miek/LibreCAL/Hardware/LibreCAL/LibreCAL.kicad_pcb

## KiCad design Hardware/LibreCAL/LibreCAL.kicad_pcb (2024-06-10)

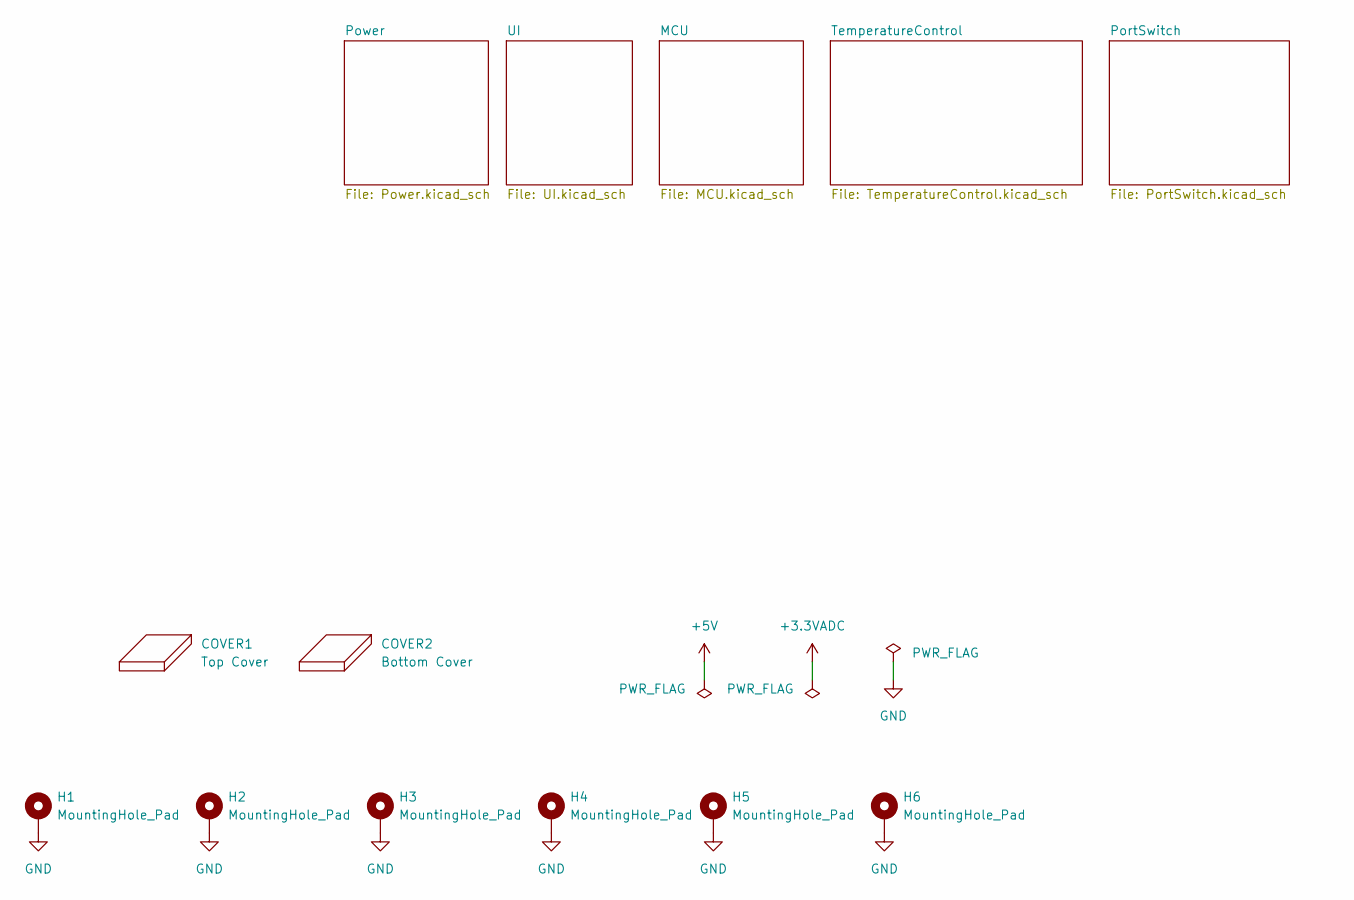
[picture p1: schematic LibreCAL.kicad_sch]

Parts:
COVER1: Top Cover; TopCover; LCSC_Part NA
COVER2: Bottom Cover; BottomCover; LCSC_Part NA
H1, H2, H3, H4, H5, H6: MountingHole_Pad; MountingHole_3.2mm_M3_ISO14580_Pad_TopBottom; LCSC_Part NA

Connections:
GND: H1.1, H2.1, H3.1, H4.1, H5.1, H6.1; also elsewhere on the board

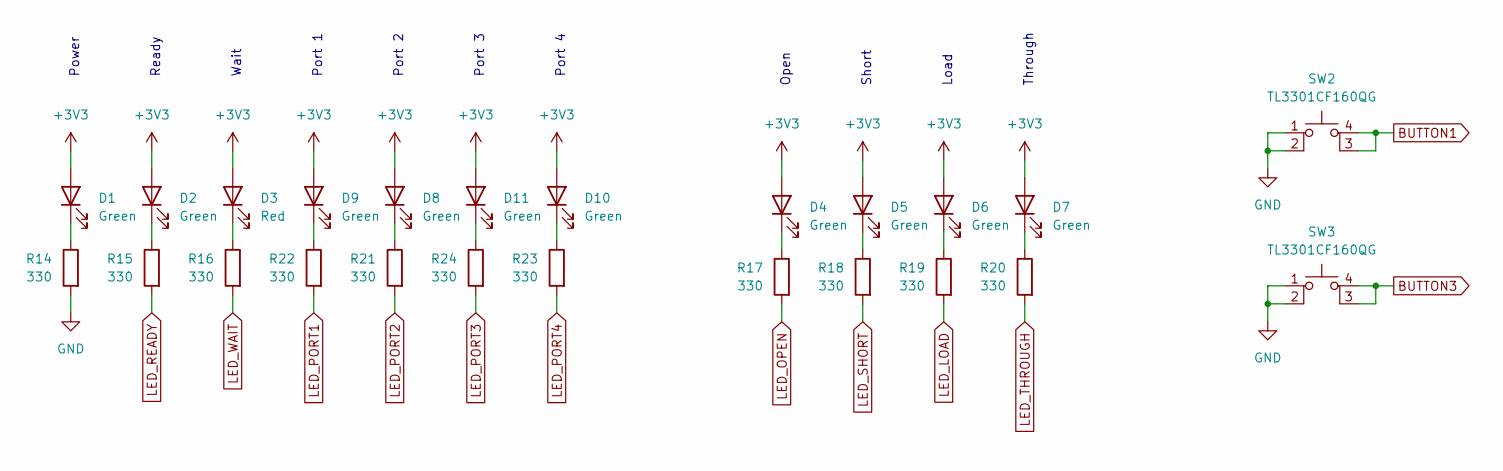
[picture p2: schematic UI.kicad_sch, LibreCAL]

Parts:
D1, D2, D4, D5, D6, D7, D8, D9, D10, D11: Green; LED_0603_1608Metric; LCSC_Part C72043
D3: Red; LED_0603_1608Metric; LCSC_Part C93128
R14, R15, R16, R17, R18, R19, R20, R21, R22, R23, R24: 330; R_0402_1005Metric; LCSC_Part C25104
SW2, SW3: TL3301CF160QG; TL3301C-J; LCSC_Part C273522

Connections:
+3V3: D1.2 (A), D2.2 (A), D3.2 (A), D4.2 (A), D5.2 (A), D6.2 (A), D7.2 (A), D8.2 (A), D9.2 (A), D10.2 (A), D11.2 (A); also elsewhere on the board
BUTTON1: SW2.3 (K), SW2.4 (A); also elsewhere on the board
BUTTON3: SW3.3 (K), SW3.4 (A); also elsewhere on the board
GND: R14.2, SW2.1, SW2.2, SW3.1, SW3.2; also elsewhere on the board
LED_LOAD: R19.2; also elsewhere on the board
LED_OPEN: R17.2; also elsewhere on the board
LED_PORT1: R22.2; also elsewhere on the board
LED_PORT2: R21.2; also elsewhere on the board
LED_PORT3: R24.2; also elsewhere on the board
LED_PORT4: R23.2; also elsewhere on the board
LED_READY: R15.2; also elsewhere on the board
LED_SHORT: R18.2; also elsewhere on the board
LED_THROUGH: R20.2; also elsewhere on the board
LED_WAIT: R16.2; also elsewhere on the board
unnamed: D1.1 (K), R14.1
unnamed: D2.1 (K), R15.1
unnamed: D3.1 (K), R16.1
unnamed: D4.1 (K), R17.1
unnamed: D5.1 (K), R18.1
unnamed: D6.1 (K), R19.1
unnamed: D7.1 (K), R20.1
unnamed: D8.1 (K), R21.1
unnamed: D9.1 (K), R22.1
unnamed: D10.1 (K), R23.1
unnamed: D11.1 (K), R24.1

Notes on the sheet:
Short
Port 3
Power
Port 1
Through
Wait
Port 2
Ready
Open
Load
Port 4

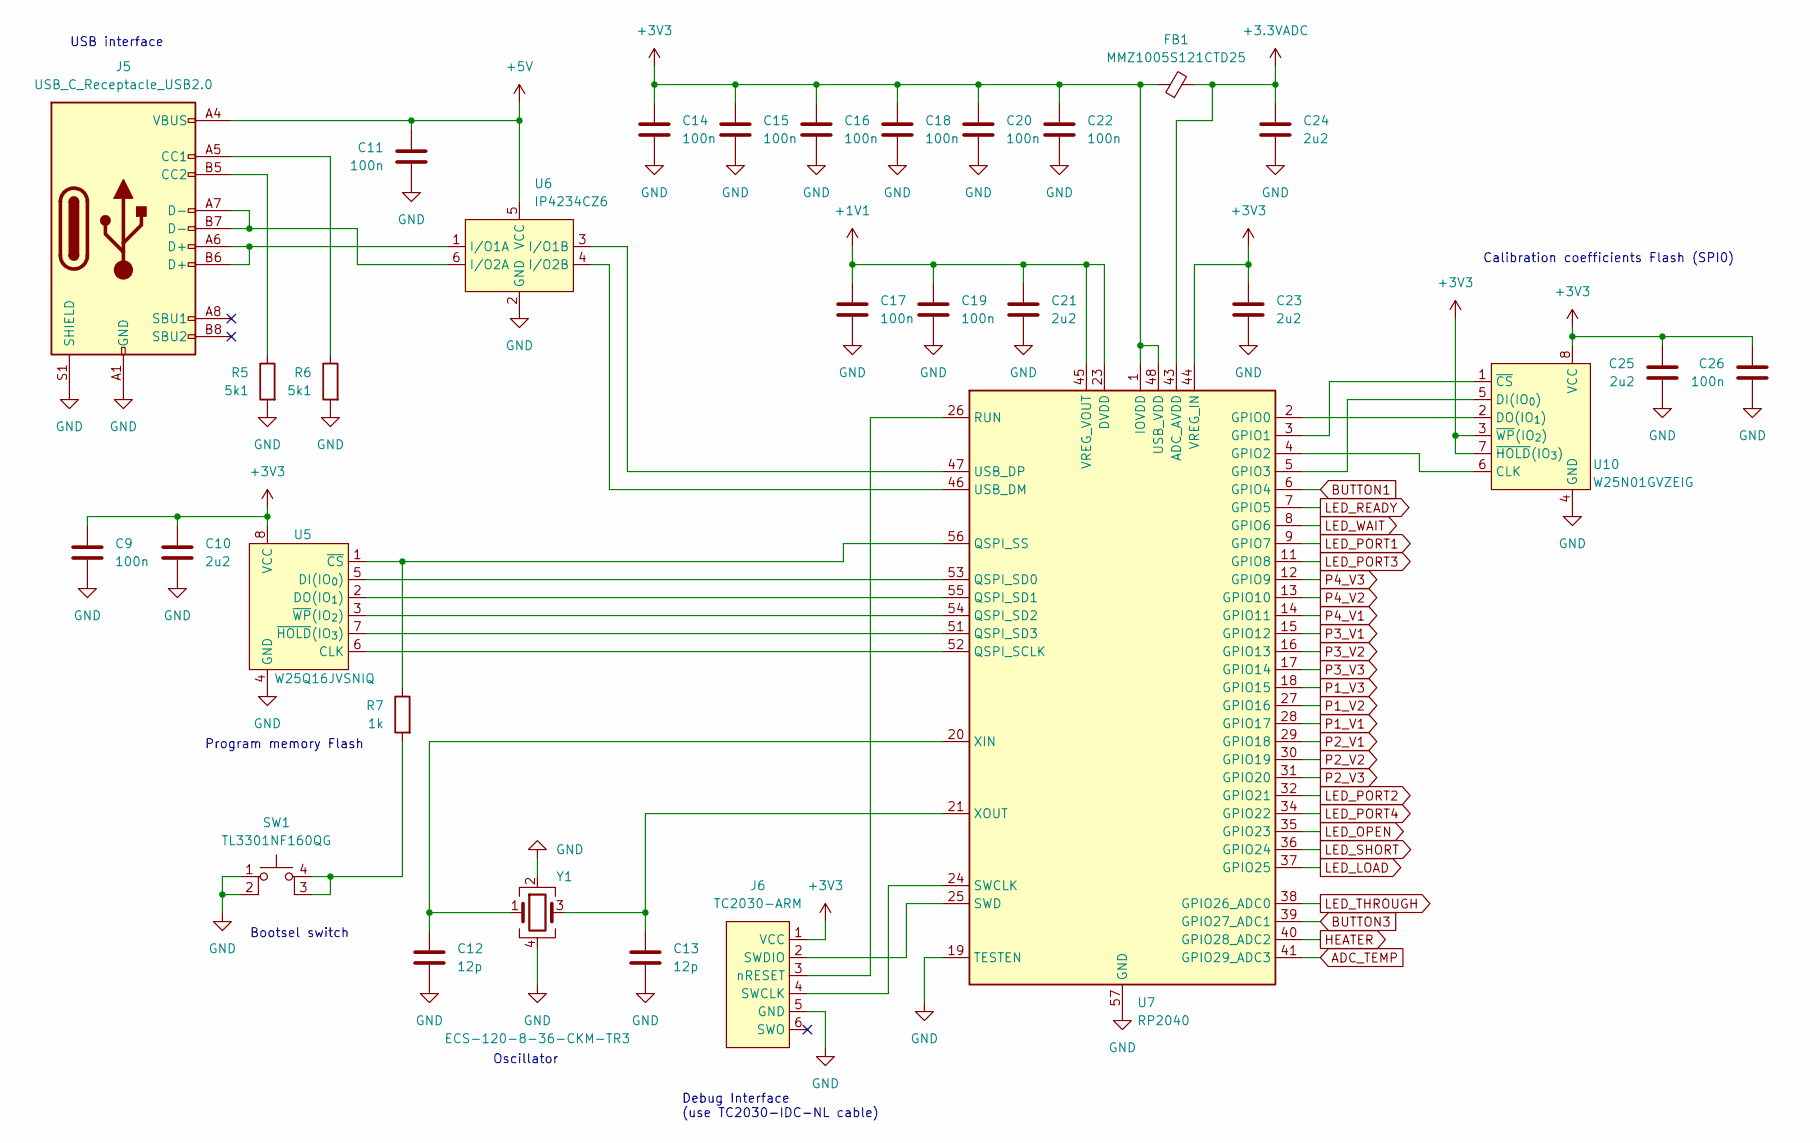
[picture p3: schematic MCU.kicad_sch, LibreCAL]

Parts:
C9, C11, C14, C15, C16, C17, C18, C19, C20, C22, C26: 100n; C_0402_1005Metric; LCSC_Part C307331
C10, C21, C23, C24, C25: 2u2; C_0402_1005Metric; LCSC_Part C307418
C12, C13: 12p; C_0402_1005Metric; LCSC_Part C76948
FB1: MMZ1005S121CTD25; L_0402_1005Metric; LCSC_Part C404693
J5: USB_C_Receptacle_USB2.0; USB_C_Receptacle_HRO_TYPE-C-31-M-12; LCSC_Part C165948
J6: TC2030-ARM; Tag-Connect_TC2030-IDC-NL_2x03_P1.27mm_Vertical; LCSC_Part NA
R5, R6: 5k1; R_0402_1005Metric; LCSC_Part C105872
R7: 1k; R_0402_1005Metric; LCSC_Part C106235
SW1: TL3301NF160QG; TL3301N-J; LCSC_Part C273527
U5: W25Q16JVSNIQ; SOIC-8_3.9x4.9mm_P1.27mm; LCSC_Part C115407
U6: IP4234CZ6; SOT-23-6; LCSC_Part C455086
U7: RP2040; LCSC_Part C2040
U10: W25N01GVZEIG; WSON-8-1EP_8x6mm_P1.27mm_EP3.4x4.3mm
Y1: ECS-120-8-36-CKM-TR3; Crystal_SMD_2520-4Pin_2.5x2.0mm; LCSC_Part C5349079

Connections:
+1V1: C17.1, C19.1, C21.1, U7.23 (DVDD), U7.45 (VREG_VOUT), U7.50 (DVDD)
+3.3VADC: C24.1, FB1.2, U7.43 (ADC_AVDD); also elsewhere on the board
+3V3: C9.1, C10.1, C14.1, C15.1, C16.1, C18.1, C20.1, C22.1, C23.1, C25.1, C26.1, FB1.1, J6.1 (VCC), U5.8 (VCC), U7.1 (IOVDD), U7.10 (IOVDD), U7.22 (IOVDD), U7.33 (IOVDD), U7.42 (IOVDD), U7.44 (VREG_IN), U7.48 (USB_VDD), U7.49 (IOVDD), U10.3 (~WP(IO_{2})), U10.7 (~HOLD(IO_{3})), U10.8 (VCC); also elsewhere on the board
+5V: C11.1, J5.A4 (VBUS), J5.A9 (VBUS), J5.B4 (VBUS), J5.B9 (VBUS), U6.5 (VCC); also elsewhere on the board
ADC_TEMP: U7.41 (GPIO29_ADC3); also elsewhere on the board
BUTTON1: U7.6 (GPIO4); also elsewhere on the board
BUTTON3: U7.39 (GPIO27_ADC1); also elsewhere on the board
GND: C9.2, C10.2, C11.2, C12.2, C13.2, C14.2, C15.2, C16.2, C17.2, C18.2, C19.2, C20.2, C21.2, C22.2, C23.2, C24.2, C25.2, C26.2, J5.A1 (GND), J5.A12 (GND), J5.B1 (GND), J5.B12 (GND), J5.S1 (SHIELD), J6.5 (GND), R5.2, R6.2, SW1.1, SW1.2, U5.4 (GND), U6.2 (GND), U7.19 (TESTEN), U7.57 (GND), U10.4 (GND), U10.9 (GND), Y1.2, Y1.4; also elsewhere on the board
HEATER: U7.40 (GPIO28_ADC2); also elsewhere on the board
LED_LOAD: U7.37 (GPIO25); also elsewhere on the board
LED_OPEN: U7.35 (GPIO23); also elsewhere on the board
LED_PORT1: U7.9 (GPIO7); also elsewhere on the board
LED_PORT2: U7.32 (GPIO21); also elsewhere on the board
LED_PORT3: U7.11 (GPIO8); also elsewhere on the board
LED_PORT4: U7.34 (GPIO22); also elsewhere on the board
LED_READY: U7.7 (GPIO5); also elsewhere on the board
LED_SHORT: U7.36 (GPIO24); also elsewhere on the board
LED_THROUGH: U7.38 (GPIO26_ADC0); also elsewhere on the board
LED_WAIT: U7.8 (GPIO6); also elsewhere on the board
unnamed: J5.A5 (CC1), R6.1
unnamed: J5.B5 (CC2), R5.1
unnamed: J6.4 (SWCLK), U7.24 (SWCLK)
unnamed: J6.2 (SWDIO), U7.25 (SWD)
unnamed: J6.3 (nRESET), U7.26 (RUN)
unnamed: R7.2, SW1.3 (K), SW1.4 (A)
unnamed: U5.6 (CLK), U7.52 (QSPI_SCLK)
unnamed: U5.5 (DI(IO_{0})), U7.53 (QSPI_SD0)
unnamed: U5.2 (DO(IO_{1})), U7.55 (QSPI_SD1)
unnamed: R7.1, U5.1 (~CS), U7.56 (QSPI_SS)
unnamed: U5.7 (~HOLD(IO_{3})), U7.51 (QSPI_SD3)
unnamed: U5.3 (~WP(IO_{2})), U7.54 (QSPI_SD2)
unnamed: J5.A6 (D+), J5.B6 (D+), U6.1 (I/O1A)
unnamed: U6.3 (I/O1B), U7.47 (USB_DP)
unnamed: J5.A7 (D-), J5.B7 (D-), U6.6 (I/O2A)
unnamed: U6.4 (I/O2B), U7.46 (USB_DM)
unnamed: C12.1, U7.20 (XIN), Y1.1
unnamed: C13.1, U7.21 (XOUT), Y1.3
unnamed: U7.4 (GPIO2), U10.6 (CLK)
unnamed: U7.5 (GPIO3), U10.5 (DI(IO_{0}))
unnamed: U7.2 (GPIO0), U10.2 (DO(IO_{1}))
unnamed: U7.3 (GPIO1), U10.1 (~CS)
P1_V1: U7.28 (GPIO17); also elsewhere on the board
P1_V2: U7.27 (GPIO16); also elsewhere on the board
P1_V3: U7.18 (GPIO15); also elsewhere on the board
P2_V1: U7.29 (GPIO18); also elsewhere on the board
P2_V2: U7.30 (GPIO19); also elsewhere on the board
P2_V3: U7.31 (GPIO20); also elsewhere on the board
P3_V1: U7.15 (GPIO12); also elsewhere on the board
P3_V2: U7.16 (GPIO13); also elsewhere on the board
P3_V3: U7.17 (GPIO14); also elsewhere on the board
P4_V1: U7.14 (GPIO11); also elsewhere on the board
P4_V2: U7.13 (GPIO10); also elsewhere on the board
P4_V3: U7.12 (GPIO9); also elsewhere on the board

Notes on the sheet:
USB interface
Oscillator
Program memory Flash
Debug Interface (use TC2030-IDC-NL cable)
Bootsel switch
Calibration coefficients Flash (SPI0)

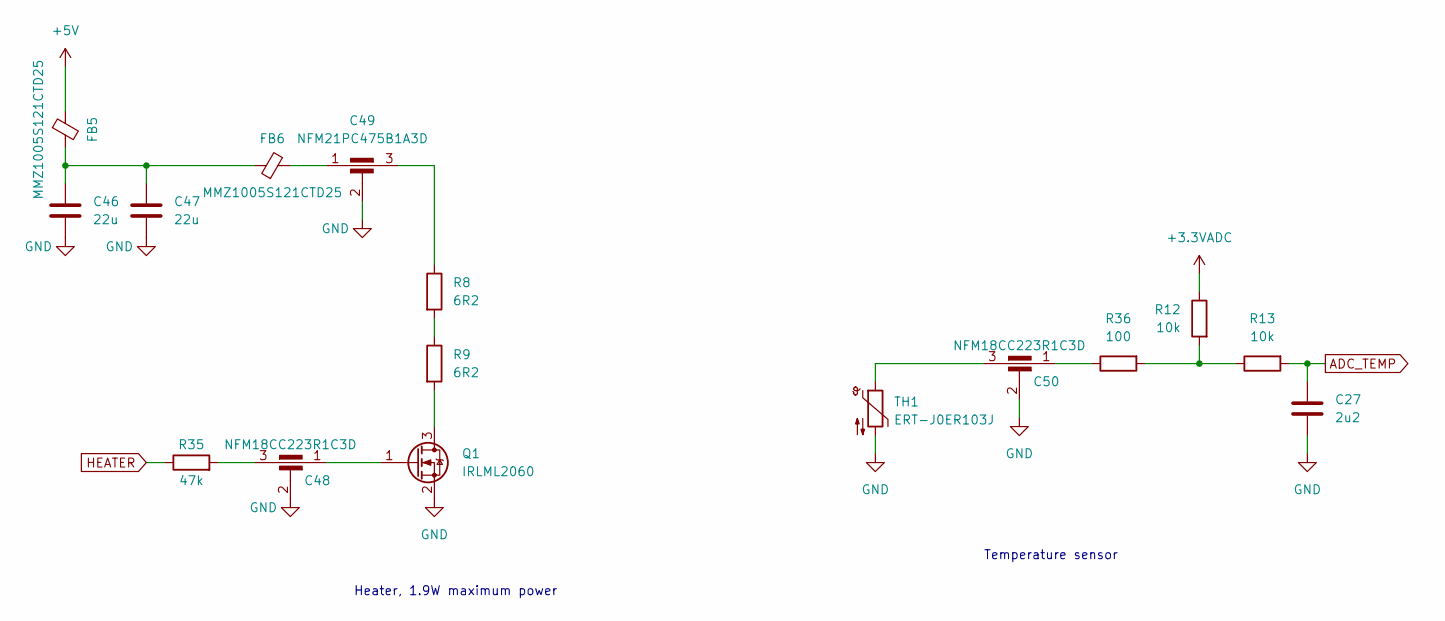
[picture p4: schematic TemperatureControl.kicad_sch, LibreCAL]

Parts:
C27: 2u2; C_0402_1005Metric; LCSC_Part C307418
C46, C47: 22u; C_0805_2012Metric; LCSC_Part C45783
C48, C50: NFM18CC223R1C3D; NFM18CC; LCSC_Part C98102
C49: NFM21PC475B1A3D; NFM21PC; LCSC_Part C96293
FB5, FB6: MMZ1005S121CTD25; L_0402_1005Metric; LCSC_Part C404693
Q1: IRLML2060; SOT-23; LCSC_Part C67275
R8, R9: 6R2; R_2512_6332Metric; LCSC_Part C147196
R12, R13: 10k; R_0402_1005Metric; LCSC_Part C723353
R35: 47k; R_0402_1005Metric; LCSC_Part C144757
R36: 100; R_0402_1005Metric; LCSC_Part C25076
TH1: ERT-J0ER103J; R_0402_1005Metric; LCSC_Part C153027

Connections:
+3.3VADC: R12.1; also elsewhere on the board
+5V: FB5.1; also elsewhere on the board
ADC_TEMP: C27.1, R13.2; also elsewhere on the board
GND: C27.2, C46.2, C47.2, C48.2, C49.2, C50.2, Q1.2 (S), TH1.2; also elsewhere on the board
HEATER: R35.1; also elsewhere on the board
unnamed: C46.1, C47.1, FB5.2, FB6.1
unnamed: C48.3, R35.2
unnamed: C49.1, FB6.2
unnamed: C49.3, R8.1
unnamed: C50.1, R36.1
unnamed: C50.3, TH1.1
unnamed: Q1.3 (D), R9.2
unnamed: C48.1, Q1.1 (G)
unnamed: R8.2, R9.1
unnamed: R12.2, R13.1, R36.2

Notes on the sheet:
Temperature sensor
Heater, 1.9W maximum power

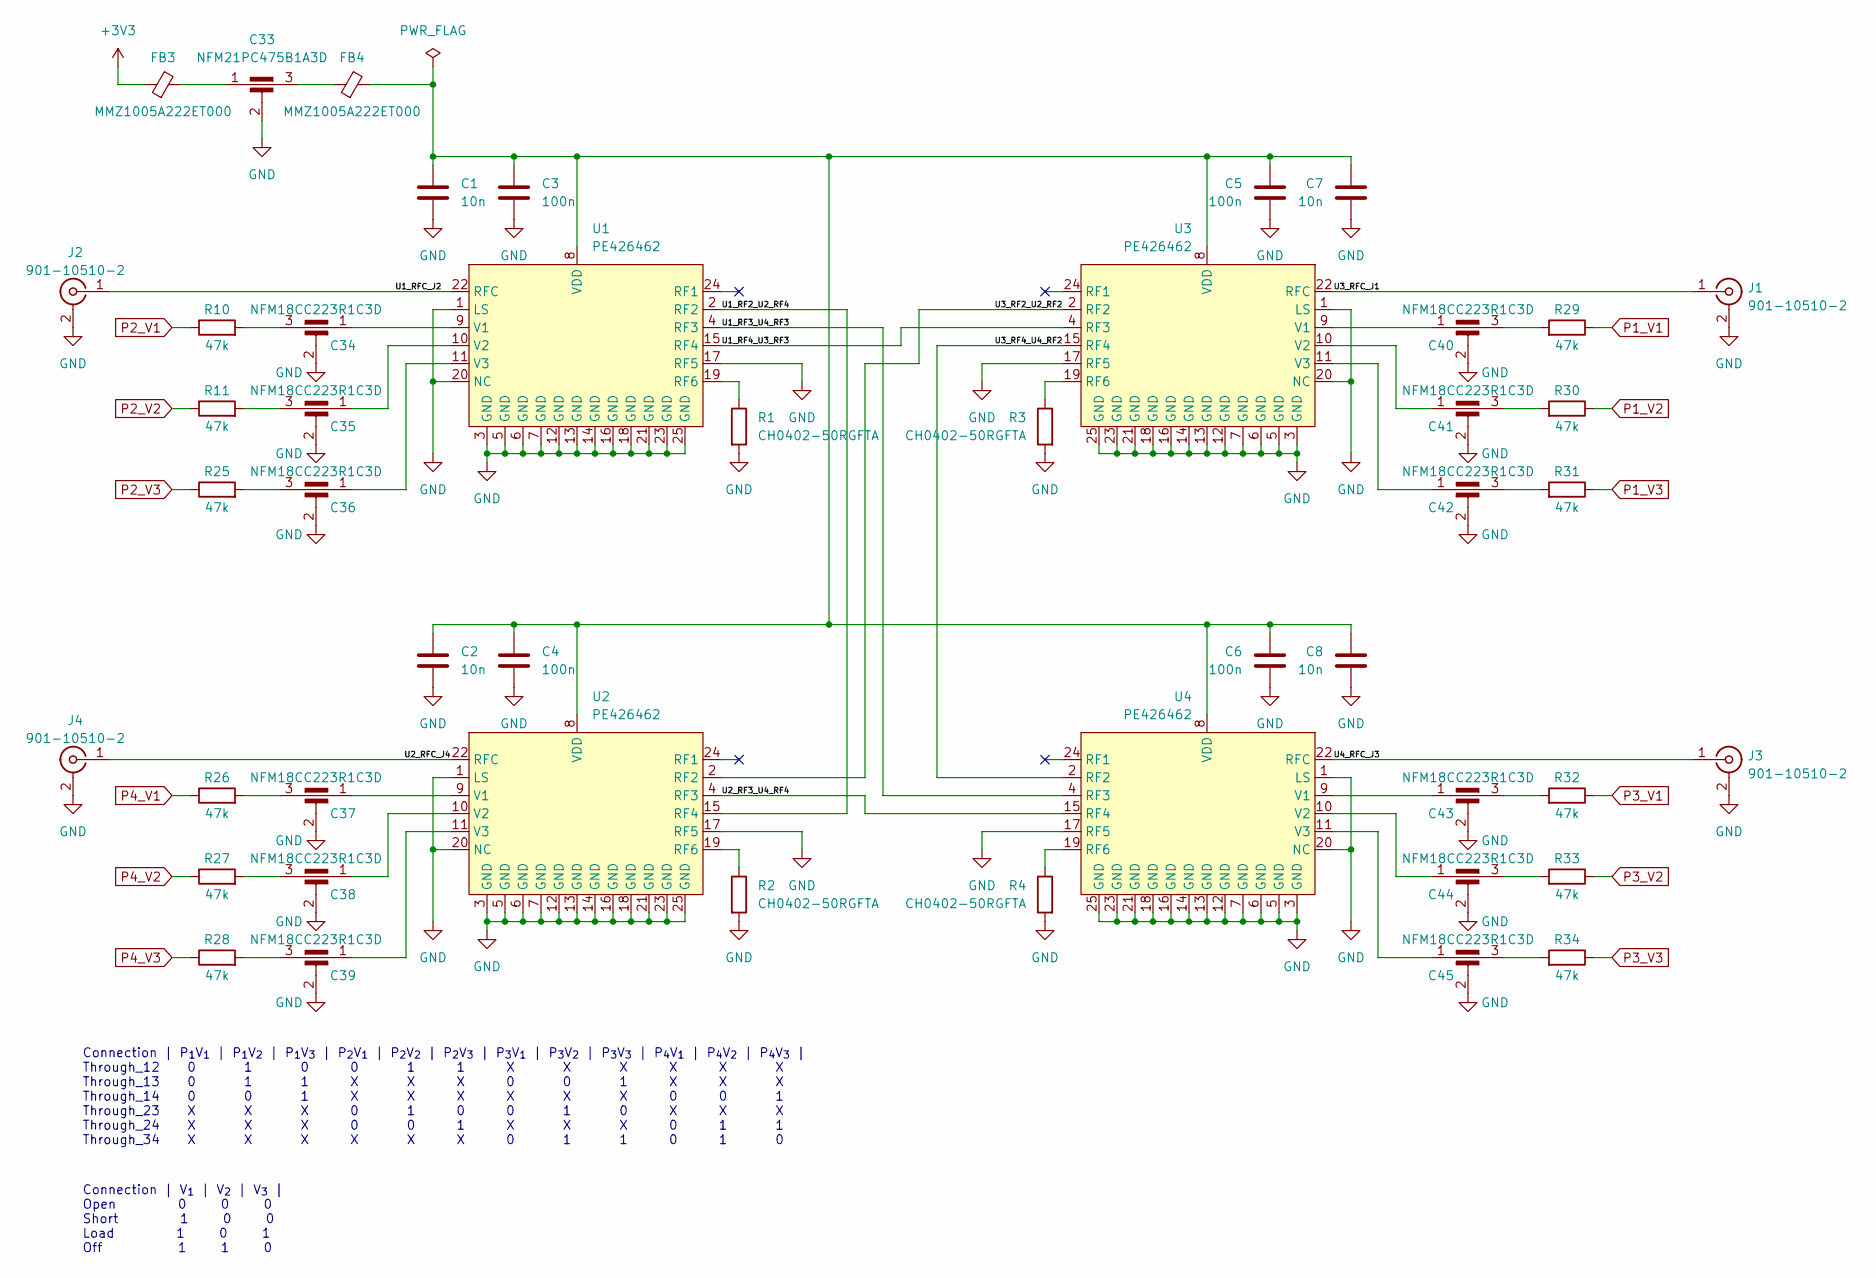
[picture p5: schematic PortSwitch.kicad_sch, LibreCAL]

Parts:
C1, C2, C7, C8: 10n; C_0402_1005Metric; LCSC_Part C15195
C3, C4, C5, C6: 100n; C_0402_1005Metric; LCSC_Part C307331
C33: NFM21PC475B1A3D; NFM21PC; LCSC_Part C96293
C34, C35, C36, C37, C38, C39, C40, C41, C42, C43, C44, C45: NFM18CC223R1C3D; NFM18CC; LCSC_Part C98102
FB3, FB4: MMZ1005A222ET000; L_0402_1005Metric; LCSC_Part C275411
J1, J2, J3, J4: 901-10510-2; LCSC_Part C3172623
R1, R2, R3, R4: CH0402-50RGFTA; R_0402_1005Metric; LCSC_Part C5349731
R10, R11, R25, R26, R27, R28, R29, R30, R31, R32, R33, R34: 47k; R_0402_1005Metric; LCSC_Part C144757
U1, U2, U3, U4: PE426462; QFN-24-1EP_4x4mm_P0.5mm_EP2.7x2.7mm; LCSC_Part C5349078

Connections:
+3V3: FB3.1; also elsewhere on the board
/PortSwitch/U1_RF2_U2_RF4: U1.2 (RF2), U2.15 (RF4)
/PortSwitch/U1_RF3_U4_RF3: U1.4 (RF3), U4.4 (RF3)
/PortSwitch/U1_RF4_U3_RF3: U1.15 (RF4), U3.4 (RF3)
/PortSwitch/U1_RFC_J2: J2.1 (In), U1.22 (RFC)
/PortSwitch/U2_RF3_U4_RF4: U2.4 (RF3), U4.15 (RF4)
/PortSwitch/U2_RFC_J4: J4.1 (In), U2.22 (RFC)
/PortSwitch/U3_RF2_U2_RF2: U2.2 (RF2), U3.2 (RF2)
/PortSwitch/U3_RF4_U4_RF2: U3.15 (RF4), U4.2 (RF2)
/PortSwitch/U3_RFC_J1: J1.1 (In), U3.22 (RFC)
/PortSwitch/U4_RFC_J3: J3.1 (In), U4.22 (RFC)
GND: C1.2, C2.2, C3.2, C4.2, C5.2, C6.2, C7.2, C8.2, C33.2, C34.2, C35.2, C36.2, C37.2, C38.2, C39.2, C40.2, C41.2, C42.2, C43.2, C44.2, C45.2, J1.2 (Ext), J1.3 (Ext), J1.4 (Ext), J1.5 (Ext), J1.6 (Ext), J1.7 (Ext), J2.2 (Ext), J2.3 (Ext), J2.4 (Ext), J2.5 (Ext), J2.6 (Ext), J2.7 (Ext), J3.2 (Ext), J3.3 (Ext), J3.4 (Ext), J3.5 (Ext), J3.6 (Ext), J3.7 (Ext), J4.2 (Ext), J4.3 (Ext), J4.4 (Ext), J4.5 (Ext), J4.6 (Ext), J4.7 (Ext), R1.2, R2.2, R3.2, R4.2, U1.1 (LS), U1.3 (GND), U1.5 (GND), U1.6 (GND), U1.7 (GND), U1.12 (GND), U1.13 (GND), U1.14 (GND), U1.16 (GND), U1.17 (RF5), U1.18 (GND), U1.20 (NC), U1.21 (GND), U1.23 (GND), U1.25 (GND), U2.1 (LS), U2.3 (GND), U2.5 (GND), U2.6 (GND), U2.7 (GND), U2.12 (GND), U2.13 (GND), U2.14 (GND), U2.16 (GND), U2.17 (RF5), U2.18 (GND), U2.20 (NC), U2.21 (GND), U2.23 (GND), U2.25 (GND), U3.1 (LS), U3.3 (GND), U3.5 (GND), U3.6 (GND), U3.7 (GND), U3.12 (GND), U3.13 (GND), U3.14 (GND), U3.16 (GND), U3.17 (RF5), U3.18 (GND), U3.20 (NC), U3.21 (GND), U3.23 (GND), U3.25 (GND), U4.1 (LS), U4.3 (GND), U4.5 (GND), U4.6 (GND), U4.7 (GND), U4.12 (GND), U4.13 (GND), U4.14 (GND), U4.16 (GND), U4.17 (RF5), U4.18 (GND), U4.20 (NC), U4.21 (GND), U4.23 (GND), U4.25 (GND); also elsewhere on the board
unnamed: C33.1, FB3.2
unnamed: C33.3, FB4.1
unnamed: C34.3, R10.2
unnamed: C35.3, R11.2
unnamed: C36.3, R25.2
unnamed: C37.3, R26.2
unnamed: C38.3, R27.2
unnamed: C39.3, R28.2
unnamed: C40.3, R29.2
unnamed: C41.3, R30.2
unnamed: C42.3, R31.2
unnamed: C43.3, R32.2
unnamed: C44.3, R33.2
unnamed: C45.3, R34.2
unnamed: R1.1, U1.19 (RF6)
unnamed: C34.1, U1.9 (V1)
unnamed: C35.1, U1.10 (V2)
unnamed: C36.1, U1.11 (V3)
unnamed: C1.1, C2.1, C3.1, C4.1, C5.1, C6.1, C7.1, C8.1, FB4.2, U1.8 (VDD), U2.8 (VDD), U3.8 (VDD), U4.8 (VDD)
unnamed: R2.1, U2.19 (RF6)
unnamed: C37.1, U2.9 (V1)
unnamed: C38.1, U2.10 (V2)
unnamed: C39.1, U2.11 (V3)
unnamed: R3.1, U3.19 (RF6)
unnamed: C40.1, U3.9 (V1)
unnamed: C41.1, U3.10 (V2)
unnamed: C42.1, U3.11 (V3)
unnamed: R4.1, U4.19 (RF6)
unnamed: C43.1, U4.9 (V1)
unnamed: C44.1, U4.10 (V2)
unnamed: C45.1, U4.11 (V3)
P1_V1: R29.1; also elsewhere on the board
P1_V2: R30.1; also elsewhere on the board
P1_V3: R31.1; also elsewhere on the board
P2_V1: R10.1; also elsewhere on the board
P2_V2: R11.1; also elsewhere on the board
P2_V3: R25.1; also elsewhere on the board
P3_V1: R32.1; also elsewhere on the board
P3_V2: R33.1; also elsewhere on the board
P3_V3: R34.1; also elsewhere on the board
P4_V1: R26.1; also elsewhere on the board
P4_V2: R27.1; also elsewhere on the board
P4_V3: R28.1; also elsewhere on the board

Notes on the sheet:
Connection | P_{1}V_{1} | P_{1}V_{2} | P_{1}V_{3} | P_{2}V_{1} | P_{2}V_{2} | P_{2}V_{3} | P_{3}V_{1} | P_{3}V_{2} | P_{3}V_{3} | P_{4}V_{1} | P_{4}V_{2} | P_{4}V_{3} | Through_12 0 1 0 0 1 1 X X X X X X Through_13 0 1 1 X X X 0 0 1 X X X Through_14 0 0 1 X X X X X X 0 0 1 Through_23 X X X 0 1 0 0 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
Connection | V_{1} | V_{2} | V_{3} | Open 0 0 0 Short 1 0 0 Load 1 0 1 Off 1 1 0

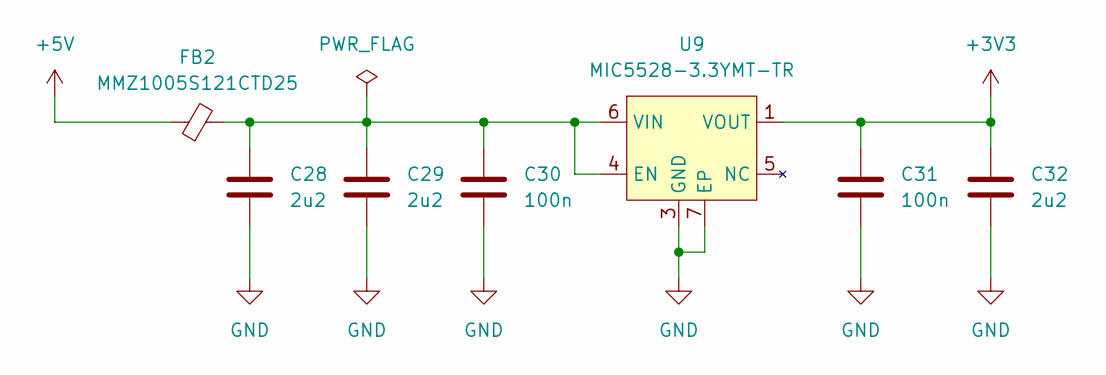
[picture p6: schematic Power.kicad_sch, LibreCAL]

Parts:
C28, C29, C32: 2u2; C_0402_1005Metric; LCSC_Part C307418
C30, C31: 100n; C_0402_1005Metric; LCSC_Part C307331
FB2: MMZ1005S121CTD25; L_0402_1005Metric; LCSC_Part C404693
U9: MIC5528-3.3YMT-TR; DFN-6-1EP_1.2x1.2mm_P0.4mm_EP0.3x0.94mm; LCSC_Part C622490

Connections:
+3V3: C31.1, C32.1, U9.1 (VOUT), U9.2 (VOUT); also elsewhere on the board
+5V: FB2.1; also elsewhere on the board
GND: C28.2, C29.2, C30.2, C31.2, C32.2, U9.3 (GND), U9.7 (EP); also elsewhere on the board
unnamed: C28.1, C29.1, C30.1, FB2.2, U9.4 (EN), U9.6 (VIN)

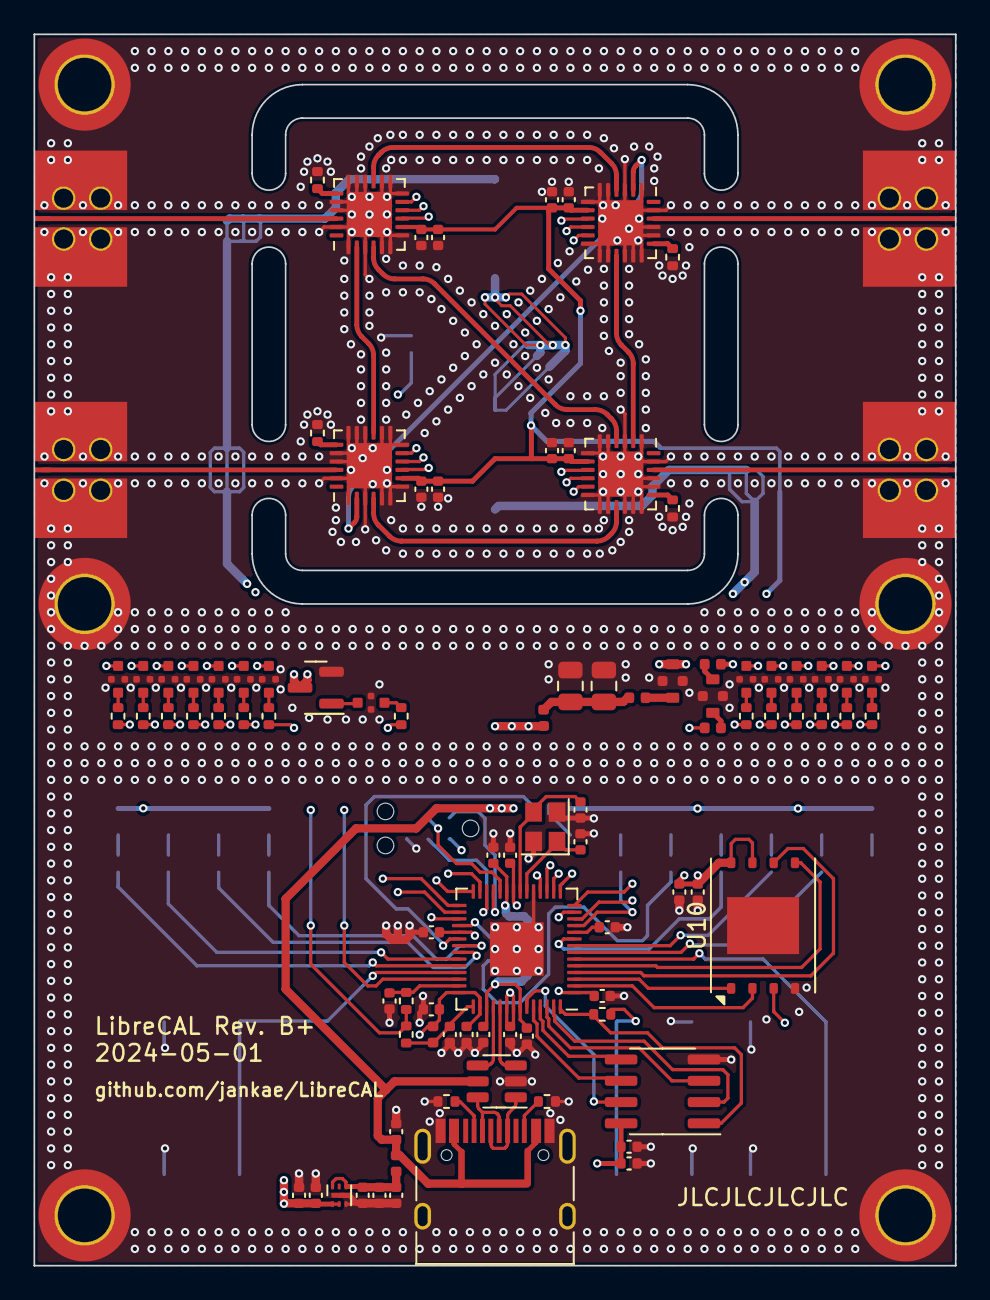
[picture p7: board LibreCAL.kicad_pcb from above]

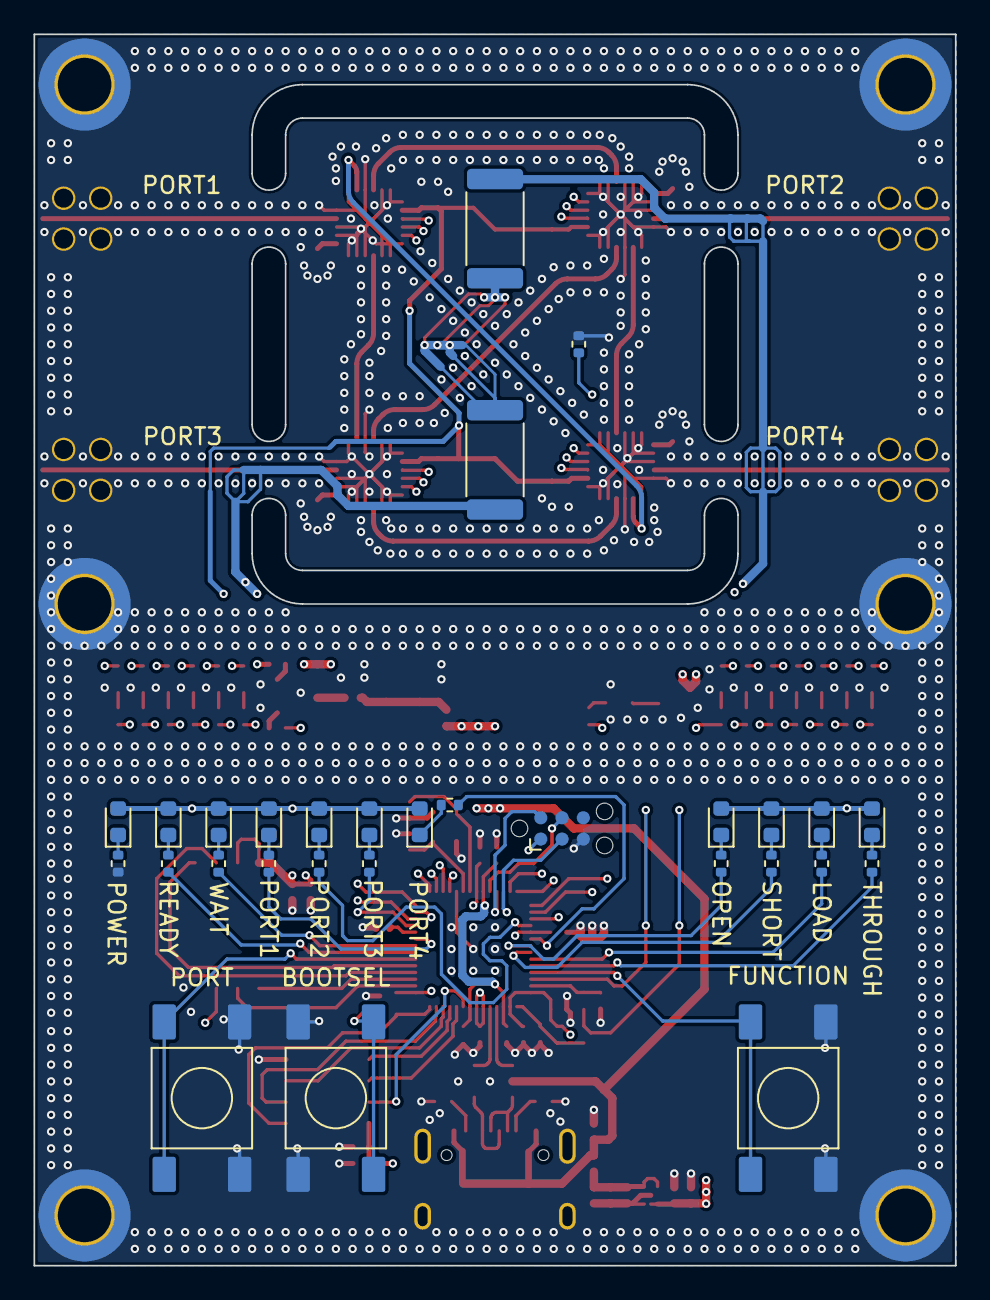
[picture p8: board LibreCAL.kicad_pcb from below]

Board: 4 copper layers, 55.0 x 73.5 mm, 132 parts (30 on the bottom side), 116 nets.
