miek/LibreCAL/(commit log)

2024-01-19 Reduce zone clearance to match GCPW clearance
    [LibreCAL.kicad_pcb]
2024-02-24 Upgrade to KiCad 8
    [LibreCAL.kicad_pcb, LibreCAL.kicad_sch, MCU.kicad_sch, PortSwitch.kicad_sch, Power.kicad_sch, TemperatureControl.kicad_sch, UI.kicad_sch]
2024-02-24 Switch to W25N01GVZEIG 1Gbit flash
    [LibreCAL.kicad_pcb, MCU.kicad_sch]
2024-04-27 Rev B+ 2024-04-27
    [LibreCAL.kicad_pcb]
2024-06-10 wip: add 1gbit flash
    [LibreCAL.kicad_pcb]
